gustavosilveiragss/pin/case/montagem.html

# Montagem do pin

Case 3D com os componentes nos lugares reais (layout invertido: placa no chao, bateria mezanino no topo). Renders do OpenSCAD, dims reais. O OLED fica SOLTO por fora (ligado por jumpers pelo buraco de cabos) e nao entra na simulacao. Gira/edita em case/montagem.scad.

Caixa (base+tampa)Perfboard 10x12ESP32-C3 SuperMiniTP4056 USB-CBateria LiPo 503035Chave / Botao

## Broche (montado)

case montado

Corpo + tampa parafusados (M2x5). Carga USB-C, chave e botao nas paredes. O buraco no rimo +Y passa os jumpers do OLED (que fica por fora).

## Explodido (as pecas)

vista explodida

De cima: tampa, bateria, base com TP4056 / perfboard+ESP / chave / botao.

## Corte (empilhamento)

corte vertical

Baixo → cima: perfboard (postes do chao) / TP4056 mezanino / bateria (mezanino, presa pela tampa).

## Base aberta

base com eletronica

Base sem tampa/bateria: TP4056 mezanino e a placa embaixo.

## Componentes

Caixa (base+tampa) | impressa, PLA/PETG
Perfboard 10x12 | ESP + R1 + R2, no chao
ESP32-C3 SuperMini | sobre a placa
TP4056 USB-C | mezanino, carga
Bateria LiPo 503035 | mezanino no topo
Chave / Botao | SS-12D00 / tactil 6x6

Parafusos: 10x M2x5 auto-atarraxante (4 tampa + 4 placa no chao + 2 TP4056). Furos que voce abre: 4 da perfboard e 2 pads do TP4056 → 2.0mm.
