gustavosilveiragss/pin/(commit log)

2026-07-02 smart pin esp32
2026-07-16 case 3d
2026-07-27 case: tp4056 e tampa
2026-07-28 bateria 1500mah
2026-07-28 sinal: ajustes de tela
2026-07-28 docs: remove estimativa de bateria
2026-07-28 firmware: porta de upload
2026-07-28 circuito: remove c1
2026-07-28 esquematica: resistor zigue-zague
2026-07-28 case: refaz encaixes botao chave usb
2026-07-30 bateria: mede nos gaps do radio em vez de nunca
2026-07-30 bundle: rejeita estouro de offset no .pin
2026-07-30 player: servico do radio em blob sem frame
2026-08-03 proximidade: conecta no boot e de defasado (setTxPower, esp_now uma vez)
